jhon17391/CAMAI/partes adicionales/Partes adicionales.pdf

## Partes adicionales

## Raspberry Pi 4 Ordenador Modelo B 8GB

https://www.amazon.com/-/es/Raspberry-Ordenador-ordenadorconveniente-construir/dp/B0899VXM8F (https://www.amazon.com/-/es/Raspberry-Ordenador-ordenador-conveniente-construir/dp/B0899VXM8F)

## Arduino Nano RP2040 Connect with headers

https://www.amazon.com/-/es/Arduino-Nano-RP2040-Conectarencabezados/dp/B095J4KFVT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 npKmCLPFD7tGOx5Y8GW2e8GI8yn5BQvYqCUz1TTUDtMM.zZy--mpVVzzrzzSj3uF1kS4phcxmcteaRFamKtkFLw&dib_tag=se&keywords=arduino+rp2040+connect&qid=17537678 75&sprefix=arduino+rp%2Caps%2C150&sr=8-3 (https://www.amazon.com/-/es/Arduino-Nano-RP2040-Conectar-encabezados/dp/B095J4KFVT)

## Bateria de Litio 7.4V

https://www.amazon.com/-/es/baterías-recargables-adaptador-cargadoradecuado/dp/B0BZ3P2VRX/ref=sr_1_10?crid=23EQEGK8OFVVH&dib=eyJ2IjoiMSJ9.7ew7sO5WltVg9GnHQQA3kUS5xvhjNosnGXEZUsqM_1Rla3C3SXzPpwN8bHQIzFXZSxIOnXYMHHKY86V3Wc2S -YMQoRrXE4NVc9JoeCvuupBlnmEPM7frP3zh9Z9LS_v_P1iz_S3rw4y8W-0x2KiKnqNrOhFJy3CXV3oV4itE1UXh0fbCQ NzSTnKbe0NN1M7vezTVa3yMP9IuE77ij31_e1v14kc2SVgaptUjpyKU9PDT_Hc zUGyzpJoVCyMPuPj9NqEcms9SLu1MXCcdT4p0OzWXcQRwQFGZipsk6vmg_ M.y9tmVf5Pcz-RA63vPe42wYaxIg3Whs5iK-Hle_78hcc&dib_tag=se&keywords=bateria+litio+7.4+v&qid=1753767987&sp refix=7.4+liti%2Caps%2C149&sr=8-10 (https://www.amazon.com/-/es/bater%C3%ADas-recargables-adaptador-cargador-adecuado/dp/B0BZ3P2VRX)

## Webcam

https://www.amazon.com/EMEET-C960-transmisión-micrófonosconferencias/dp/B0C4NCJ5K5/ref=sr_1_1_sspa?__mk_es_US=ÅMÅŽÕÑ&crid=FZYFNTZGHMDA&dib=eyJ2IjoiMSJ9.e0Xx5CtMQh-Jtk2xfYXQKSjJbWf_tFvN1UtgxqJyxIyH7KVy8J-D79cpt_yyCpOF2kUfT9QTzgj5ujwaT07WfwIyunNC-XGbQ7jiSnliC9RGhOqX35hiHJUWwUAcjzxuKSEYNxrBHNF0yccfrA5VGem-2URZQf7YUljSpawYvLFjNsoBgm8B_9DjpTP5UYbfxqDVOu82xG79_iAvdzh58p87 bwjF_46Ps3nc8A_PM0.mrvJ_V2hepAxp3b2En8qEak6GxPxKrBd6- (https://www.amazon.com/EMEET-C960-transmisi%C3%B3n-micr%C3%B3fonos-conferencias/dp/B0C4NCJ5K5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)

pzxGuQBKM&dib_tag=se&keywords=emeet%2Bwebcam&qid=1753771171&s prefix=emeet%2Bwebcam%2B%2Caps%2C148&sr=8-1-spons&sp_csd=d2lkZ2V0TmFtZT1zcF9hdGY&th=1 (https://www.amazon.com/EMEET-C960-transmisi%C3%B3n-micr%C3%B3fonos-conferencias/dp/B0C4NCJ5K5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)
