jhon17391/CAMAI/3d parts/files/BoM.xlsx

NB: all the links here listed are the ones i used to buy the components, you may find other ones with better prices/faster shipping depending on your region.
Hardware parts | n° |  | Link
M3x10 | -- |  | Hardware store
M3x16 | -- |  | Hardware store
M3x25 | -- |  | Hardware store
M3x30 | -- |  | Hardware store
8x12x3.5 bearing | 4 |  | https://www.amazon.it/Akozon-Cuscinetto-Cuscinetti-Miniatura-Schermatura/dp/B07DV2YLYV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
Offroad A959 Tyre | 4 |  | https://it.aliexpress.com/item/32924195863.html?swrs=5983092B63BE4A0A63417C7787320193 (https://www.amazon.it/Fytoo-Wltoys-Fuoristrada-Ricambi-A959-01/dp/B07HDXZY7M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)
NB: the electronics components here listed are just suggested. you can use different components as you prefer, as long as they are equivalent.
Electronics | n° |  | Link
Arduino nano | 2 | (1 tx+ 1rx) | https://it.aliexpress.com/item/32856118319.html
NRF24L01 wifi module | 2 | (1 tx+ 1rx) | https://it.aliexpress.com/item/33055955341.html?s=p&ad_pvid=202003201109433269243248194840004226533_4
1000 kv BL A2212 Motor + Esc | 1 |  | https://www.amazon.it/UNIKEL-A2212-1000kV-Brushless-Outrunner/dp/B0197ZMQIW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
2200 mAh 3s Lipo Battery | 1 |  | https://hobbyking.com/it_it/turnigy-2200mah-3s-25c-lipo-pack.html?queryID=81637ee6c0eae9524033fb73cdb205e7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
Sg 90 Servo | 1 |  | https://www.amazon.it/Longruner-servomotore-elicottero-aeroplano-LKY66-UK-5/dp/B07236KYVC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
50x70 mm PCB Board | 1 |  | https://www.amazon.it/ELEGOO-Millefori-Prototipo-Circuito-Prototype/dp/B073WR78M6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
