jhon17391/CAMAI/3d parts/files/BatteryMount.stl

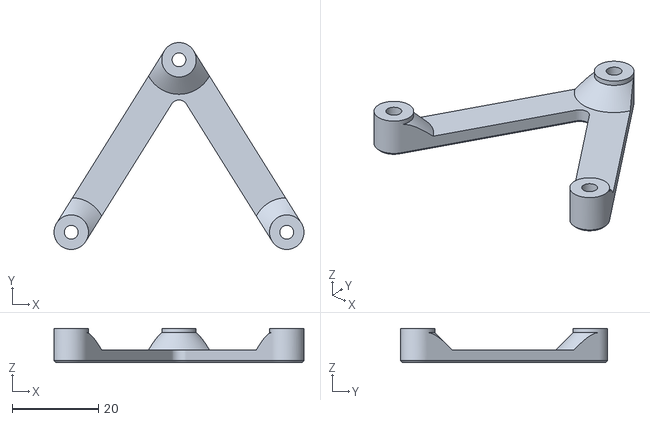
[picture p1: CAD file, 2025-09-25]
3d parts/files/BatteryMount.stl
58.0 x 48.0 x 8.00
