jhon17391/CAMAI/3d parts/rueda.stl

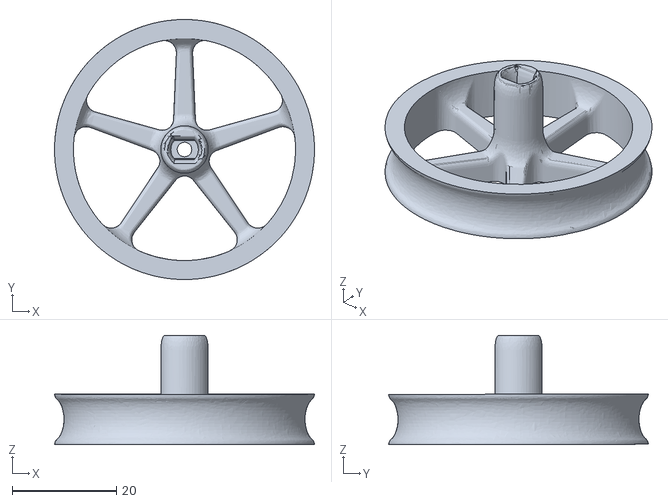
[picture p2: CAD file, 2025-07-29]
3d parts/rueda.stl
50.0 x 50.0 x 21.0
