jhon17391/CAMAI/3d parts/files/FrontBumper1.stl

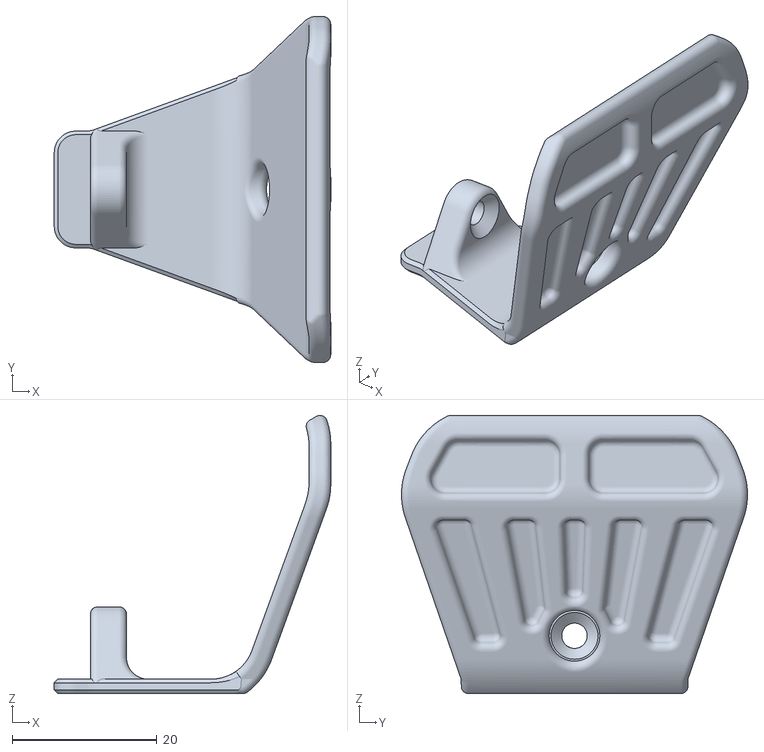
[picture p3: CAD file, 2025-09-25]
3d parts/files/FrontBumper1.stl
38.3 x 47.9 x 38.5
