jhon17391/CAMAI/3d parts/files/hecho/Front_Wheel.stl

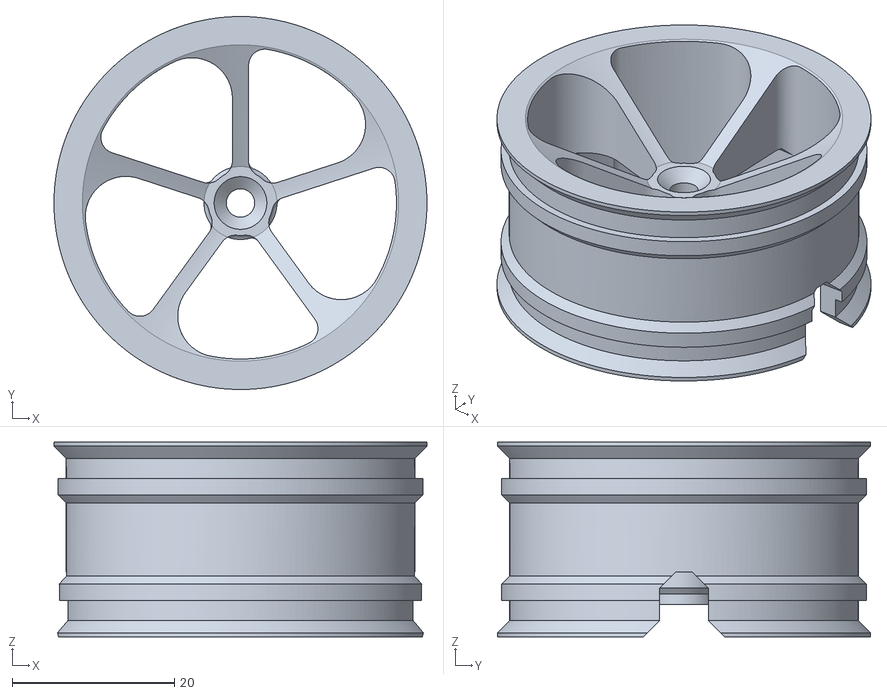
[picture p4: CAD file, 2025-09-25]
3d parts/files/hecho/Front_Wheel.stl
46.0 x 46.0 x 24.0
