jhon17391/CAMAI/3d parts/retenedor-delantero.stl

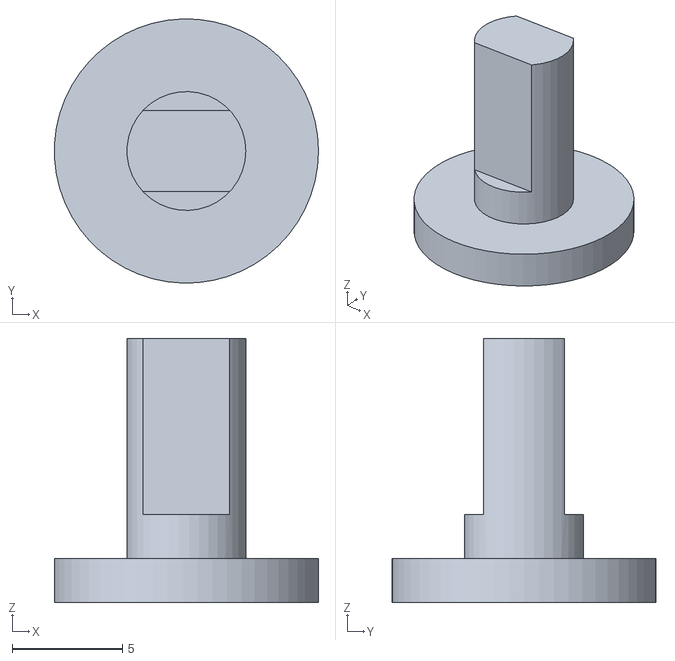
[picture p5: CAD file, 2025-07-29]
3d parts/retenedor-delantero.stl
12.0 x 12.0 x 12.0
