jhon17391/CAMAI/3d parts/carcasa-base.stl

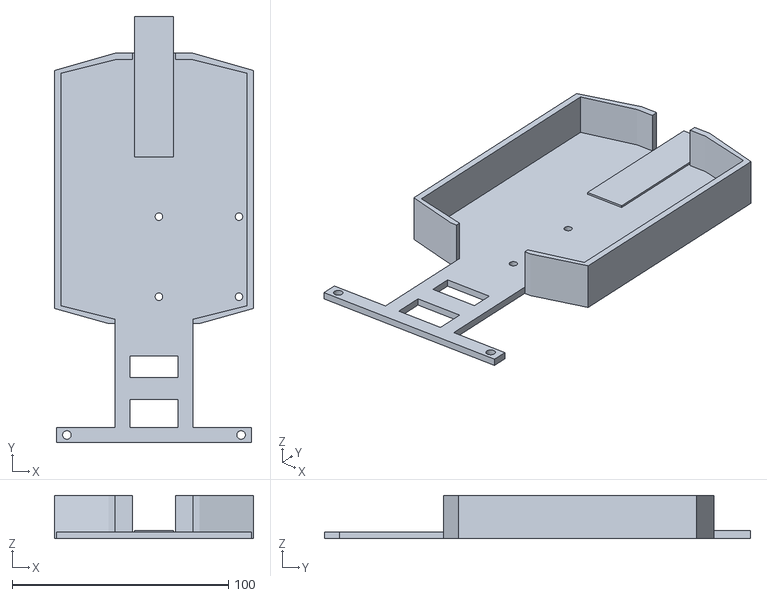
[picture p6: CAD file, 2025-07-29]
3d parts/carcasa-base.stl
92.0 x 197.0 x 20.0
