jhon17391/CAMAI/3d parts/files/hecho/Front_SuspensionBottomRight.stl

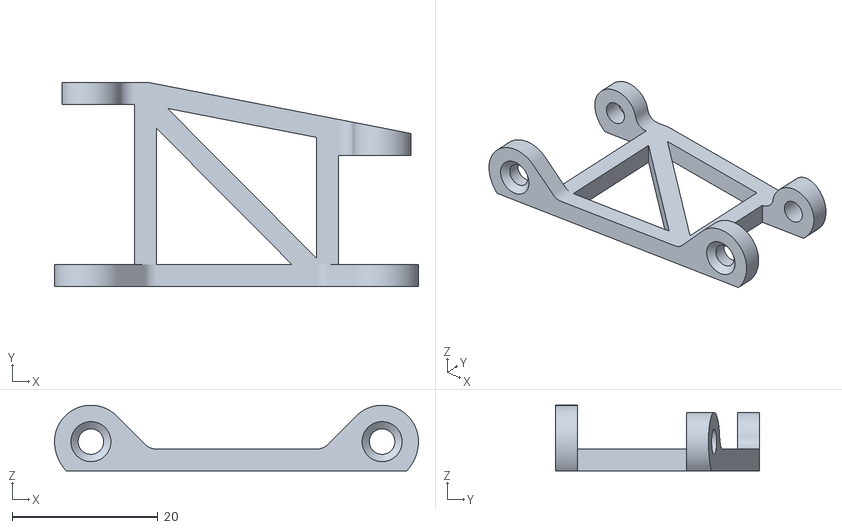
[picture p7: CAD file, 2025-09-25]
3d parts/files/hecho/Front_SuspensionBottomRight.stl
50.0 x 28.0 x 9.00
