jhon17391/CAMAI/3d parts/files/RearSuspension_Upper.stl

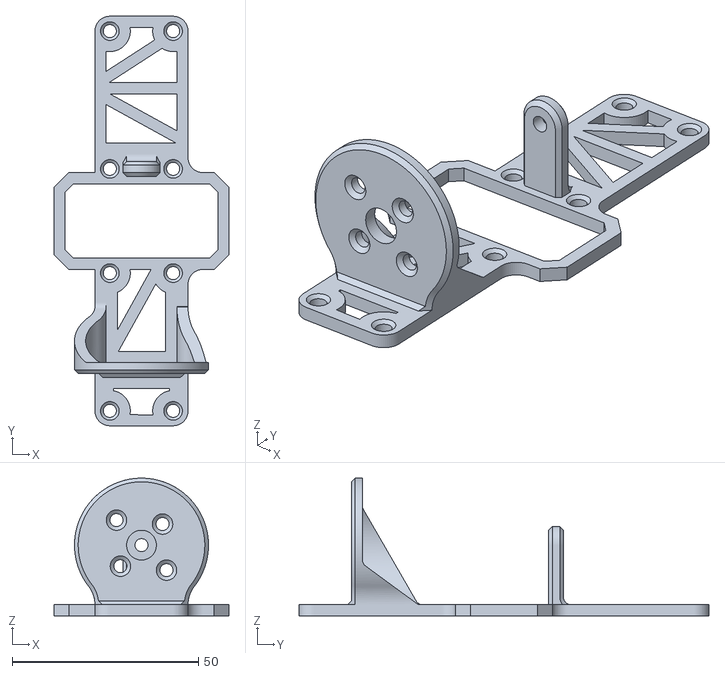
[picture p8: CAD file, 2025-09-25]
3d parts/files/RearSuspension_Upper.stl
47.0 x 110.0 x 37.0
