jhon17391/CAMAI/3d parts/files/hecho/PinionGear.stl

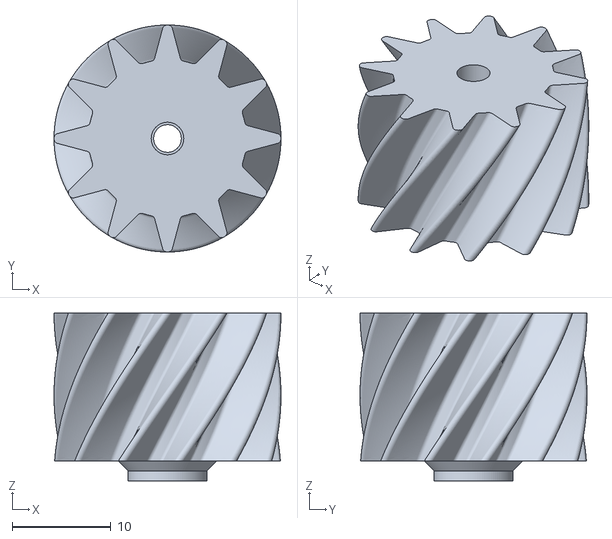
[picture p9: CAD file, 2025-09-25]
3d parts/files/hecho/PinionGear.stl
23.0 x 23.0 x 17.0
