jhon17391/CAMAI/3d parts/files/Rear_WingMountRight.stl

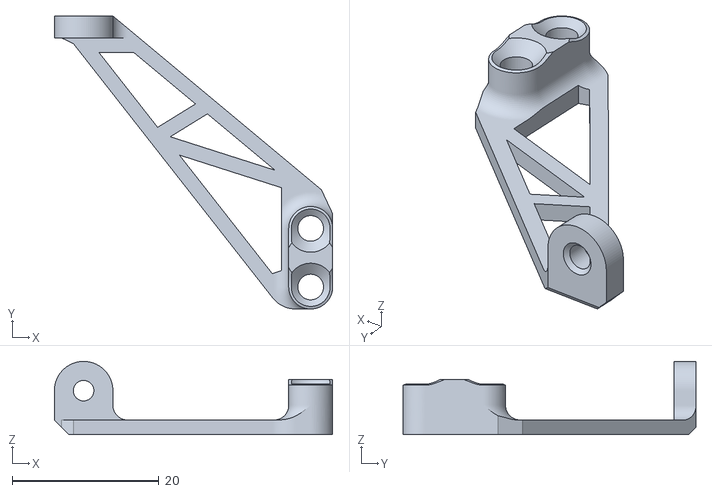
[picture p10: CAD file, 2025-09-25]
3d parts/files/Rear_WingMountRight.stl
38.0 x 40.0 x 10.0
