jhon17391/CAMAI/3d parts/soporte_servo.stl

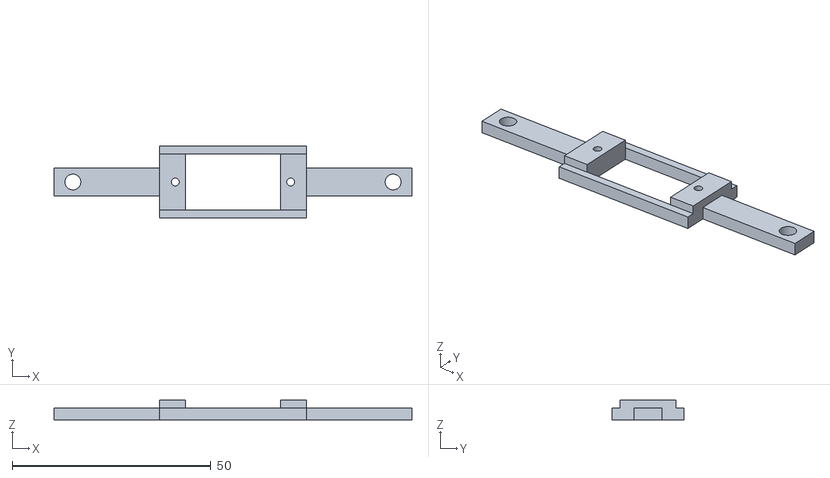
[picture p11: CAD file, 2025-07-29]
3d parts/soporte_servo.stl
90.0 x 18.0 x 5.00
