jhon17391/CAMAI/3d parts/brazo_delantero.stl

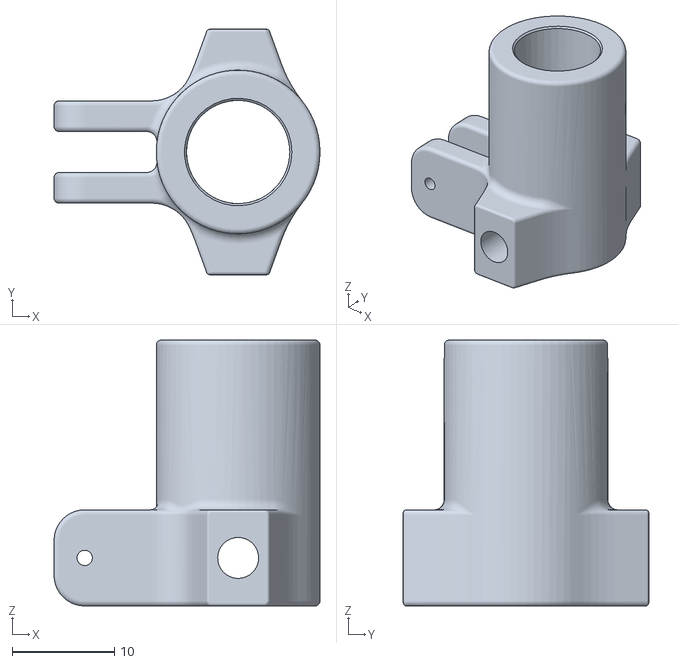
[picture p12: CAD file, 2025-07-29]
3d parts/brazo_delantero.stl
26.0 x 24.0 x 26.0
