jhon17391/CAMAI/3d parts/files/Front_WheelLock.stl

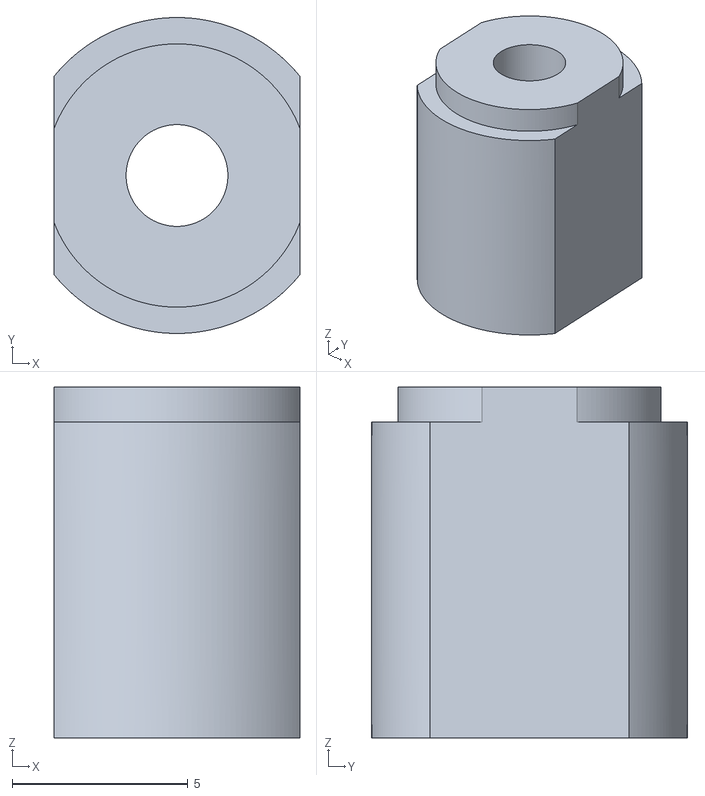
[picture p13: CAD file, 2025-09-25]
3d parts/files/Front_WheelLock.stl
7.00 x 9.00 x 10.0
