jhon17391/CAMAI/3d parts/files/hecho/Rear_Wheel.stl

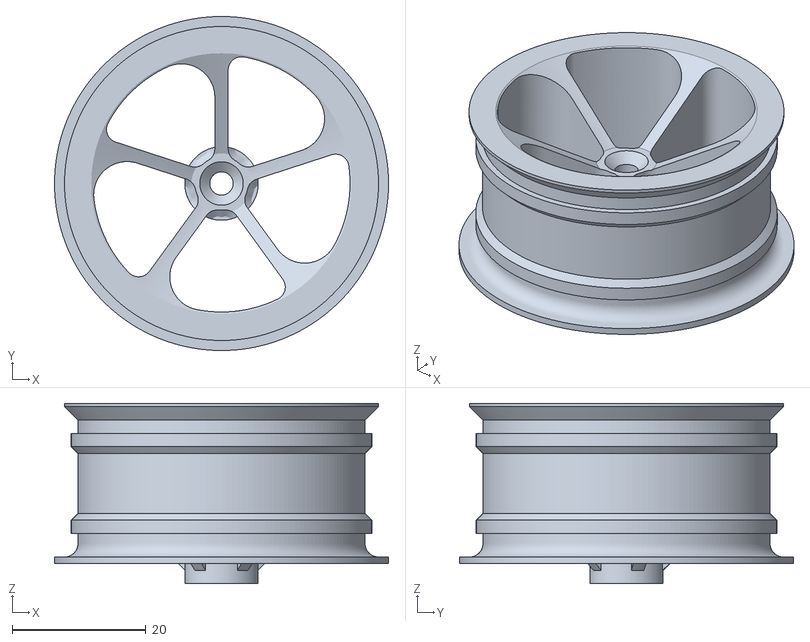
[picture p14: CAD file, 2025-09-25]
3d parts/files/hecho/Rear_Wheel.stl
50.0 x 50.0 x 27.0
