jhon17391/CAMAI/3d parts/carcasa-superior.stl

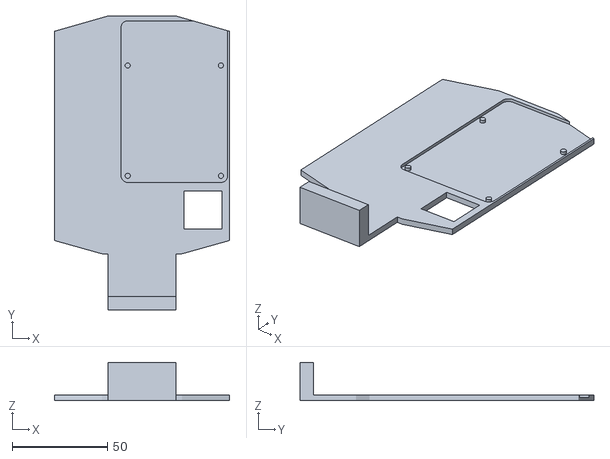
[picture p15: CAD file, 2025-07-29]
3d parts/carcasa-superior.stl
92.0 x 154.5 x 20.0
