jhon17391/CAMAI/3d parts/files/BatteryColumn.stl

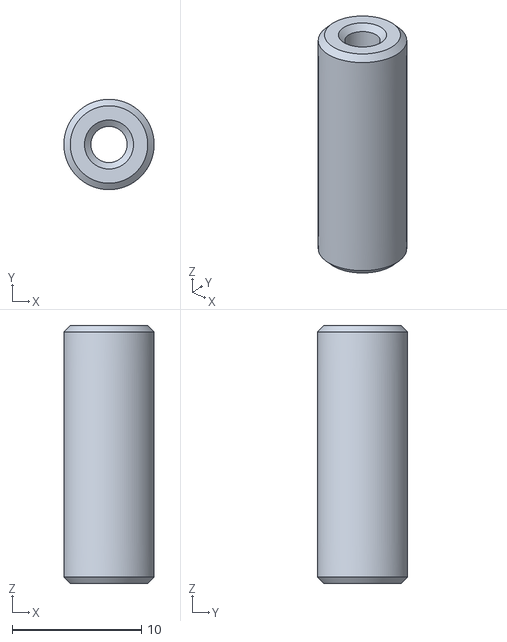
[picture p16: CAD file, 2025-09-25]
3d parts/files/BatteryColumn.stl
7.00 x 7.00 x 20.0
