jhon17391/CAMAI/3d parts/files/hecho/Chassis.stl

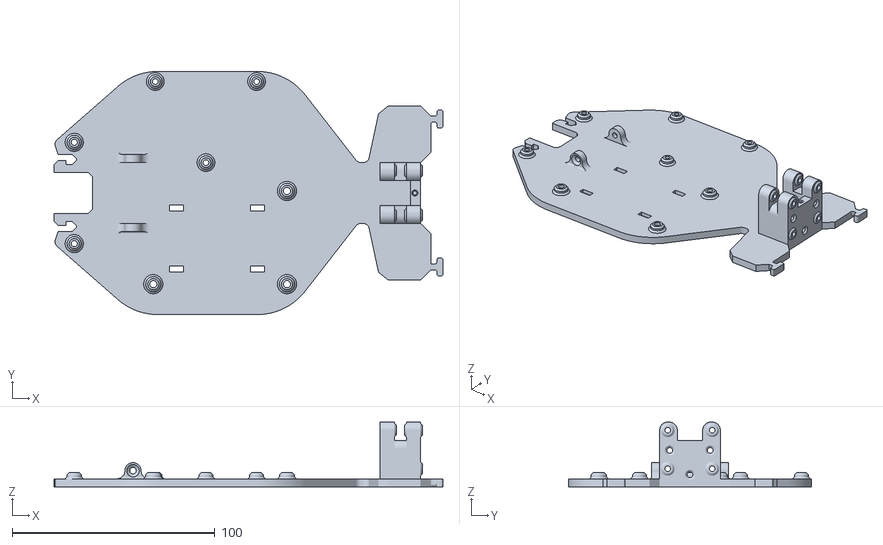
[picture p17: CAD file, 2025-09-25]
3d parts/files/hecho/Chassis.stl
192.0 x 120.0 x 32.0
