jhon17391/CAMAI/3d parts/eje_llanta.stl

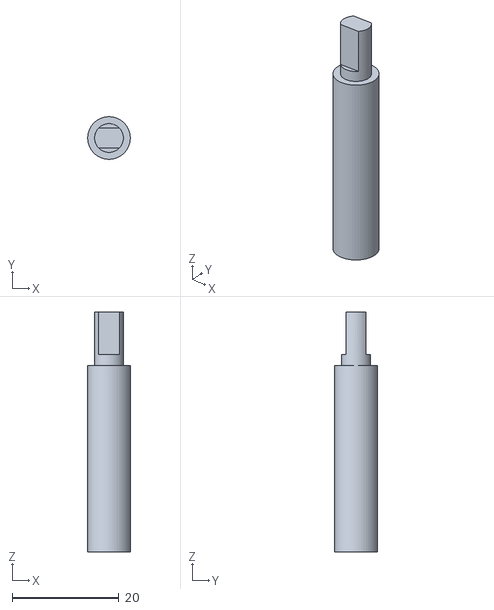
[picture p18: CAD file, 2025-07-29]
3d parts/eje_llanta.stl
8.00 x 8.00 x 45.0
