jhon17391/CAMAI/3d parts/files/hecho/Rear_Wing1.stl

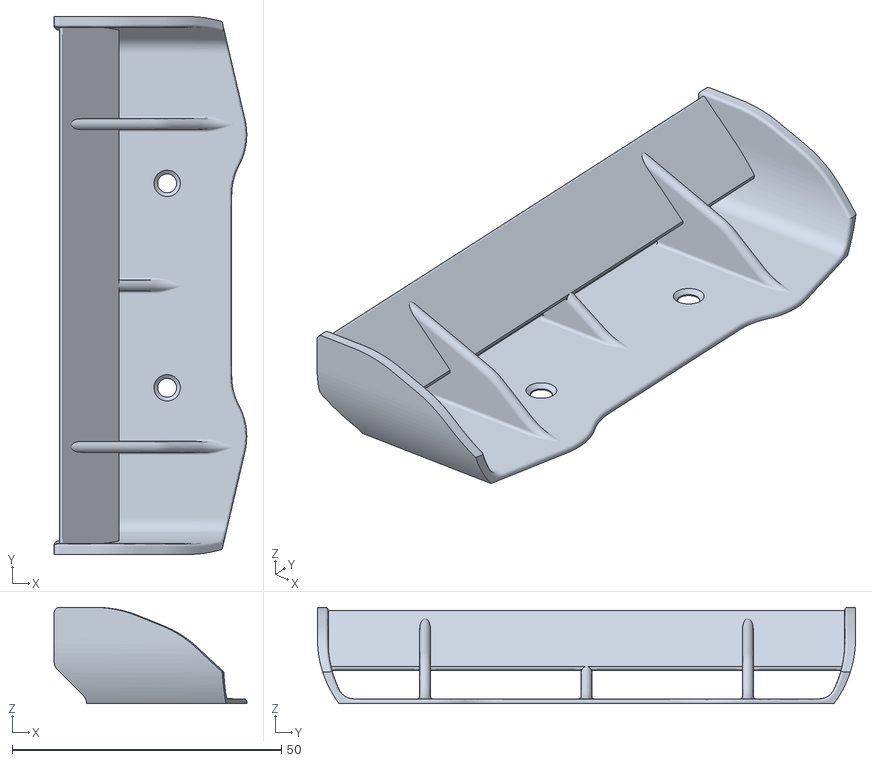
[picture p19: CAD file, 2025-09-25]
3d parts/files/hecho/Rear_Wing1.stl
35.8 x 100.0 x 17.9
