jhon17391/CAMAI/3d parts/files/RearSuspension_Hub.stl

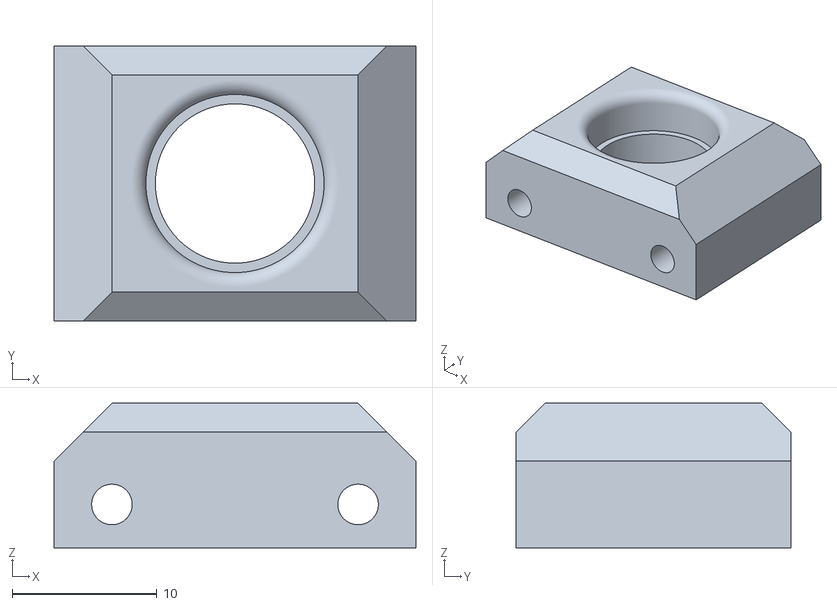
[picture p20: CAD file, 2025-09-25]
3d parts/files/RearSuspension_Hub.stl
25.0 x 19.0 x 10.0
