jhon17391/CAMAI/3d parts/carcasa-medio.stl

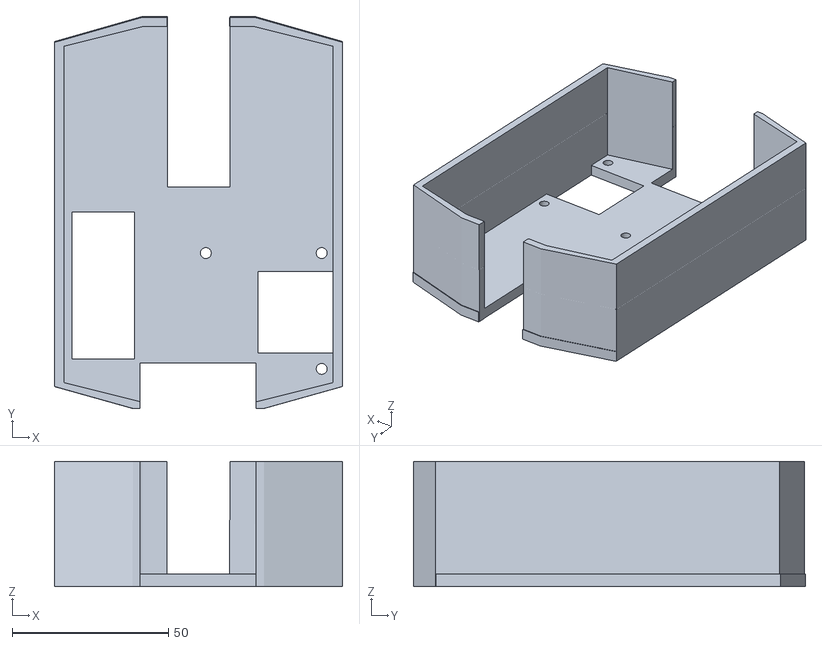
[picture p21: CAD file, 2025-07-29]
3d parts/carcasa-medio.stl
92.1 x 125.2 x 40.0
