jhon17391/CAMAI/3d parts/files/hecho/Rear_Wing2.stl

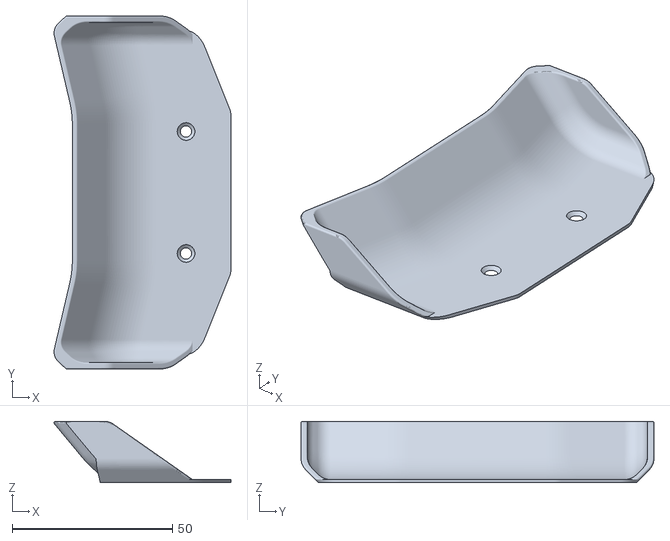
[picture p22: CAD file, 2025-09-25]
3d parts/files/hecho/Rear_Wing2.stl
55.1 x 110.0 x 19.2
