jhon17391/CAMAI/3d parts/files/RearSuspension_Bottom.stl

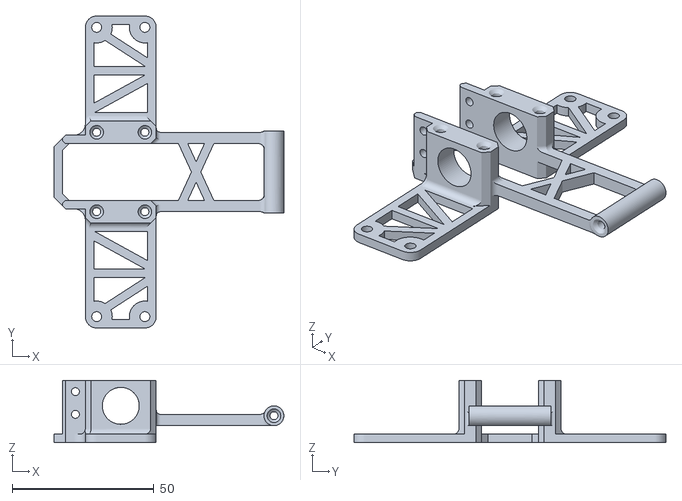
[picture p23: CAD file, 2025-09-25]
3d parts/files/RearSuspension_Bottom.stl
81.0 x 110.0 x 22.0
