jhon17391/CAMAI/3d parts/barra_direccion.stl

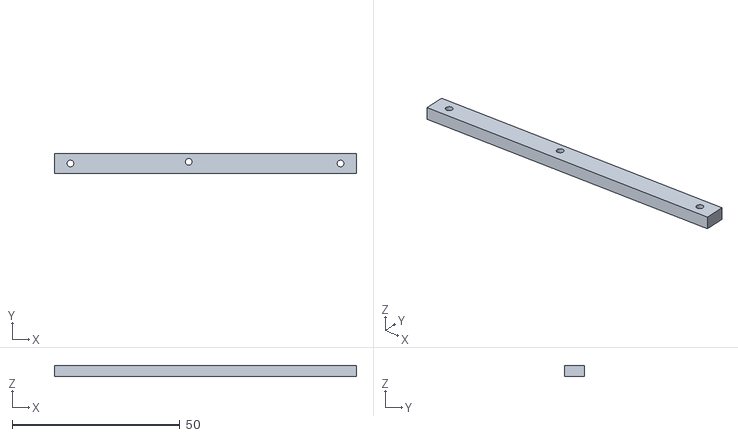
[picture p24: CAD file, 2025-07-29]
3d parts/barra_direccion.stl
90.0 x 6.00 x 3.40
