jhon17391/CAMAI/3d parts/files/hecho/Front_HubMount.stl

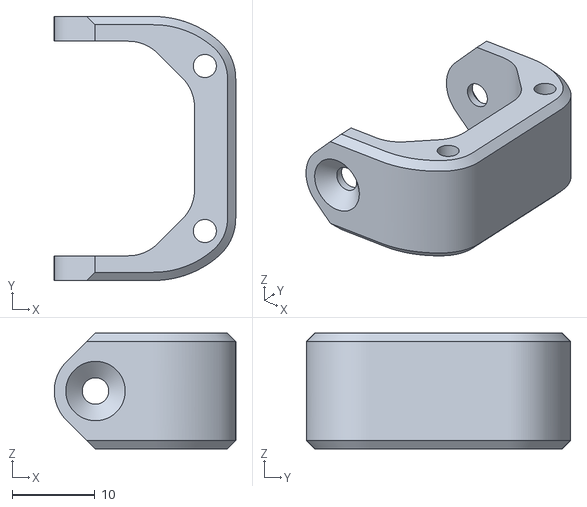
[picture p25: CAD file, 2025-09-25]
3d parts/files/hecho/Front_HubMount.stl
22.0 x 32.0 x 14.0
