jhon17391/CAMAI/3d parts/files/hecho/Front_HubLeft.stl

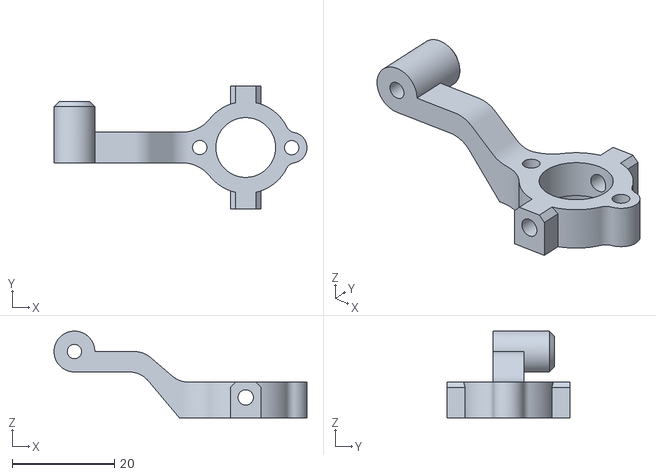
[picture p26: CAD file, 2025-09-25]
3d parts/files/hecho/Front_HubLeft.stl
49.6 x 24.0 x 17.0
