jhon17391/CAMAI/3d parts/files/hecho/Front_HubCap.stl

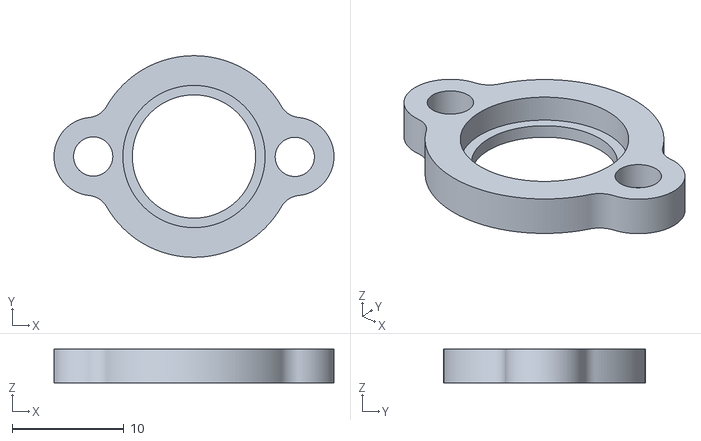
[picture p27: CAD file, 2025-09-25]
3d parts/files/hecho/Front_HubCap.stl
25.0 x 18.0 x 3.00
