jhon17391/CAMAI/3d parts/files/hecho/CrownGear.stl

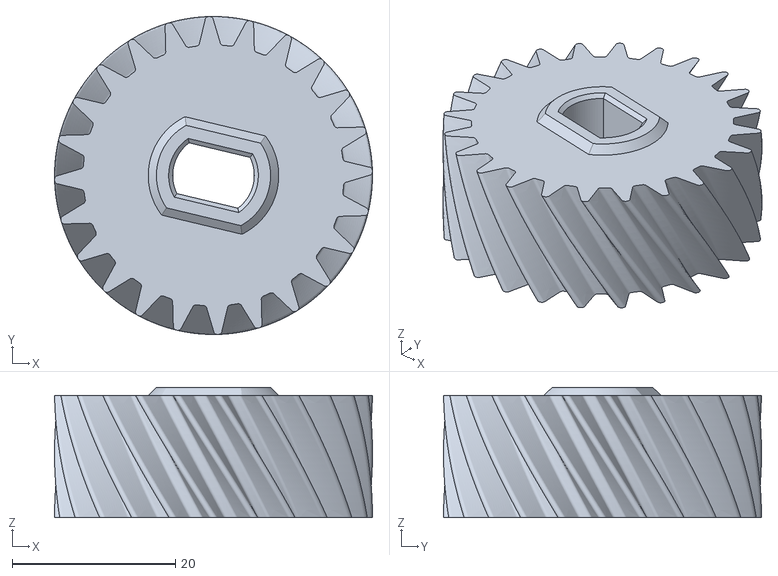
[picture p28: CAD file, 2025-09-25]
3d parts/files/hecho/CrownGear.stl
39.0 x 39.0 x 16.0
