jhon17391/CAMAI/3d parts/files/hecho/Front_SuspensionUpperRight.stl

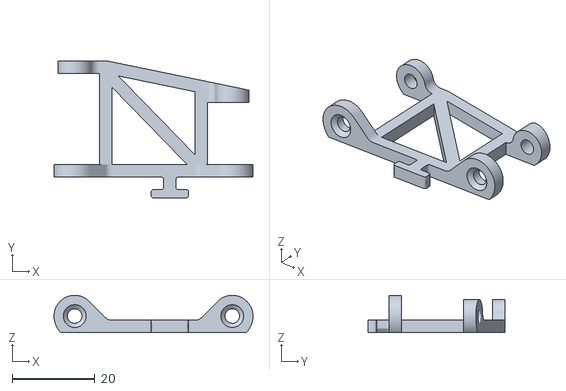
[picture p29: CAD file, 2025-09-25]
3d parts/files/hecho/Front_SuspensionUpperRight.stl
48.0 x 33.0 x 9.00
