jhon17391/CAMAI/3d parts/files/hecho/SteeringLever.stl

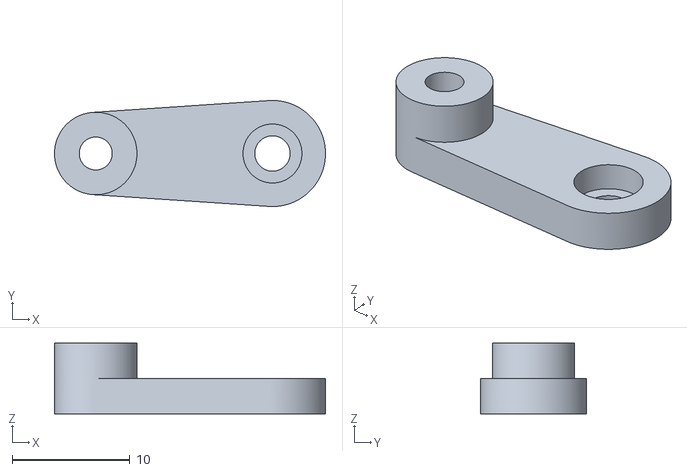
[picture p30: CAD file, 2025-09-25]
3d parts/files/hecho/SteeringLever.stl
23.0 x 9.00 x 6.00
