jhon17391/CAMAI/3d parts/files/hecho/Rear_Shaft.stl

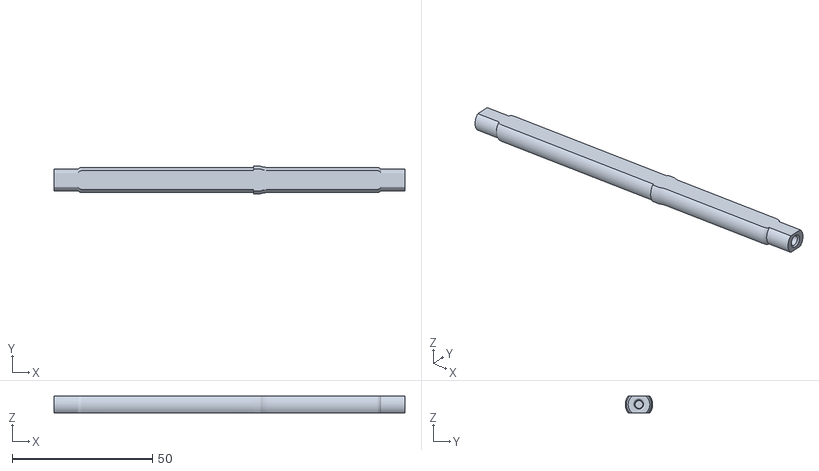
[picture p31: CAD file, 2025-09-25]
3d parts/files/hecho/Rear_Shaft.stl
125.0 x 9.80 x 6.00
