jhon17391/CAMAI/3d parts/files/hecho/steering_link_head.stl

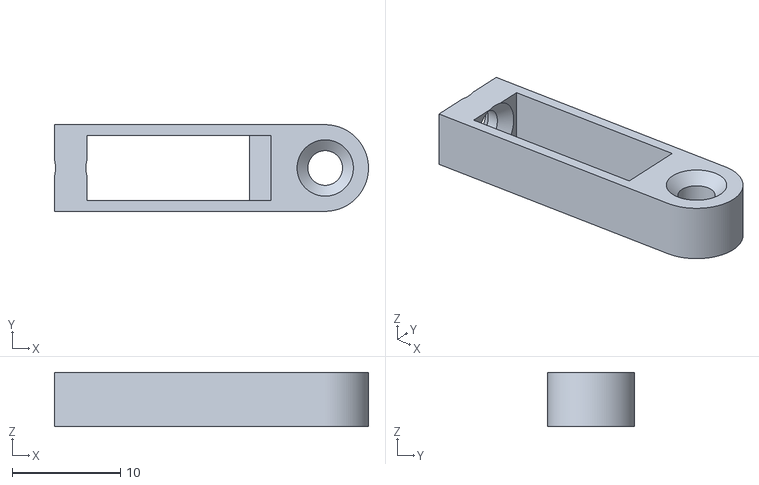
[picture p32: CAD file, 2025-09-25]
3d parts/files/hecho/steering_link_head.stl
29.0 x 8.00 x 5.00
