jhon17391/CAMAI/3d parts/files/hecho/SteeringLink.stl

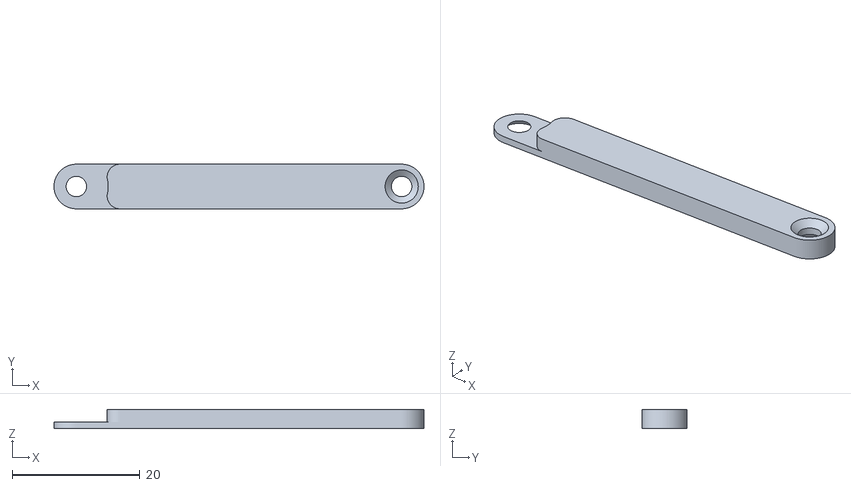
[picture p33: CAD file, 2025-09-25]
3d parts/files/hecho/SteeringLink.stl
58.0 x 7.00 x 3.00
