jhon17391/CAMAI/(list of files, cad)

Other CAD files:
3d parts/files/hecho/ElectronicsColumn.stl
3d parts/files/hecho/Front_HubRight.stl
3d parts/files/hecho/steering_link_nut.stl
